felisan99/USB-2.0-4xPORTS-HUB/USB-Hub.kicad_pcb

## KiCad design USB-Hub.kicad_pcb (2025-02-19)

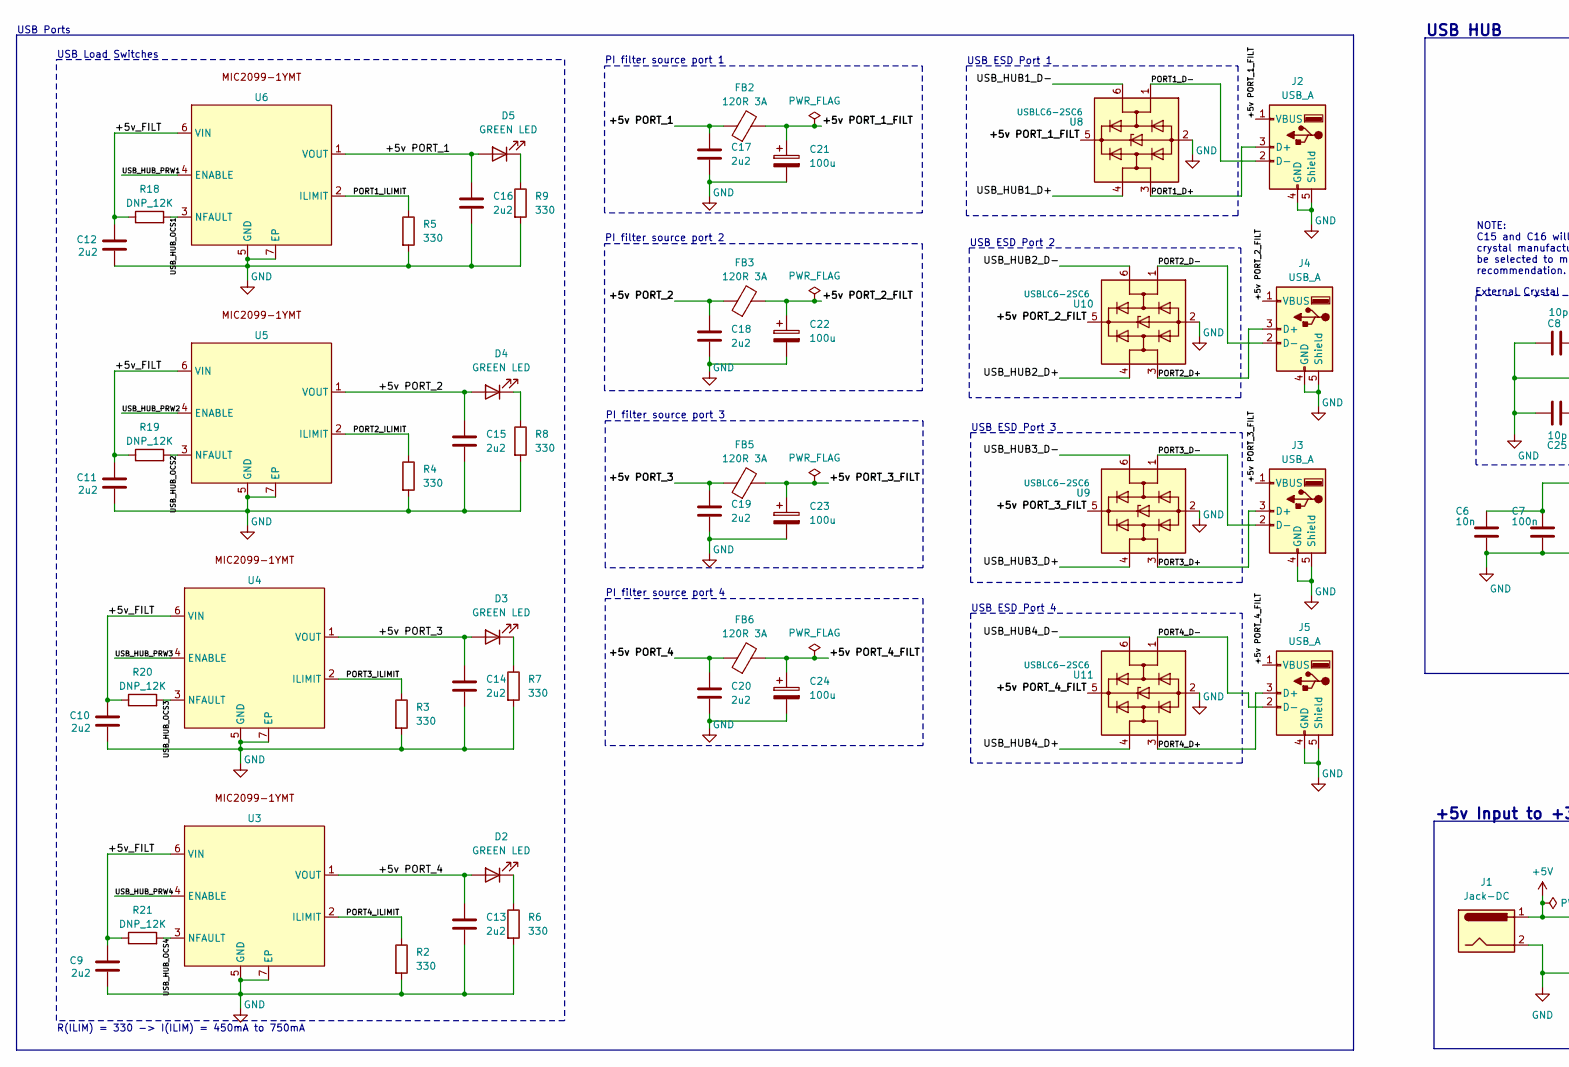
[picture p1: schematic USB-Hub.kicad_sch, USB Hub, part in row 1, column 1]

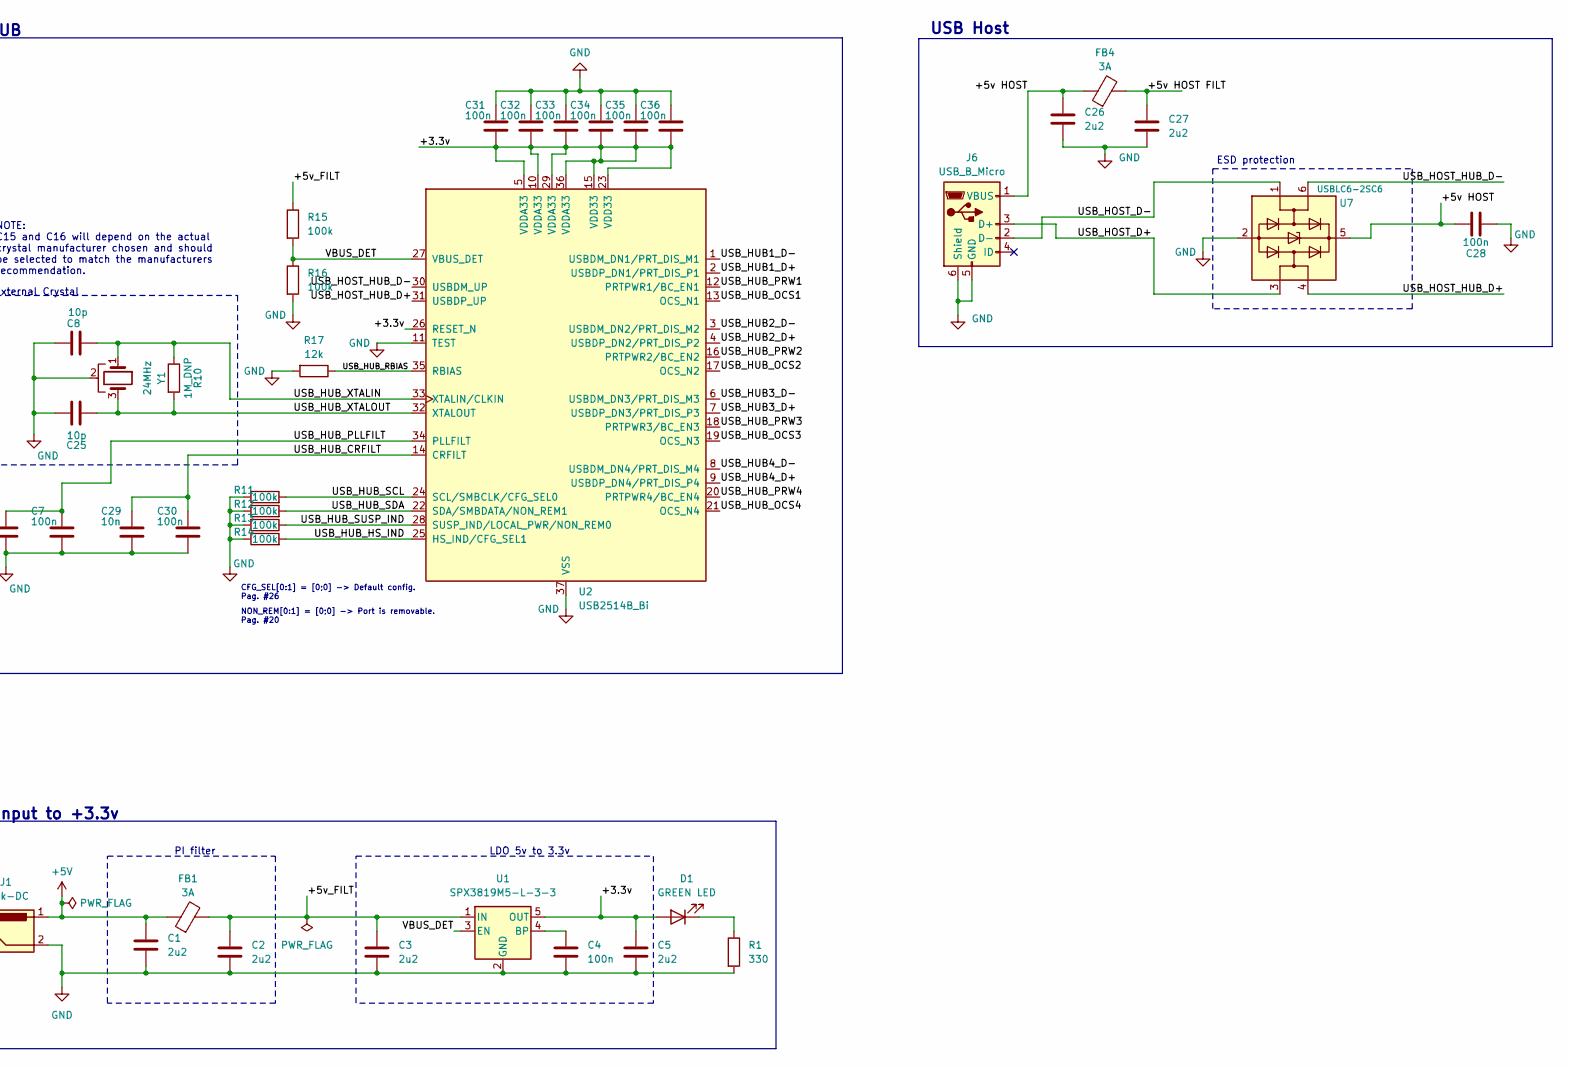
[picture p2: schematic USB-Hub.kicad_sch, USB Hub, part in row 1, column 2]

Parts:
C1, C2, C3, C5, C9, C10, C11, C12, C13, C14, C15, C16, C17, C18, C19, C20, C26, C27: 2u2; C_0805_2012Metric
C4, C7, C28, C30: 100n; C_0805_2012Metric
C6, C29: 10n; C_0603_1608Metric
C8, C25: 10p; C_0603_1608Metric
C21, C22, C23, C24: 100u; CP_Elec_6.3x3.9
C31, C32, C33, C34, C35, C36: 100n; C_0603_1608Metric
D1, D2, D3, D4, D5: GREEN LED; LED_0805_2012Metric
FB1, FB4: 3A; L_0201_0603Metric
FB2, FB3, FB5, FB6: 120R 3A; L_0201_0603Metric
J1: Jack-DC; BarrelJack_Horizontal
J2, J3, J4, J5: USB_A; USB_A_TE_292303-7_Horizontal
J6: USB_B_Micro; USB_Micro-B_Molex_47346-0001
R1, R2, R3, R4, R5, R6, R7, R8, R9: 330; R_0201_0603Metric
R10: 1M_DNP; R_0805_2012Metric
R11, R12, R13, R14, R15, R16: 100k; R_0805_2012Metric
R17: 12k; R_0201_0603Metric
R18, R19, R20, R21: DNP_12K; R_0201_0603Metric
U1: SPX3819M5-L-3-3; SOT-23-5
U2: USB2514B_Bi; QFN-36-1EP_6x6mm_P0.5mm_EP3.7x3.7mm
U3, U4, U5, U6: MIC2099-1YMT
U7, U8, U9, U10, U11: USBLC6-2SC6; SOT-23-6
Y1: 24MHz; Resonator_SMD-3Pin_7.2x3.0mm

Connections:
+5V: C1.1, FB1.1, J1.1
/+3.3v: C5.1, C31.2, C32.2, C33.2, C34.2, C35.2, C36.2, D1.2 (A), U1.5 (OUT), U2.5 (VDDA33), U2.10 (VDDA33), U2.15 (VDD33), U2.23 (VDD33), U2.26 (RESET_N), U2.29 (VDDA33), U2.36 (VDDA33)
/+5v HOST: C26.1, C28.1, FB4.1, J6.1 (VBUS), U7.5 (VBUS)
/+5v HOST FILT: C27.1, FB4.2
/+5v PORT_1: C16.1, C17.1, D5.2 (A), FB2.1, U6.1 (VOUT)
/+5v PORT_1_FILT: C21.1, FB2.2, J2.1 (VBUS), U8.5 (VBUS)
/+5v PORT_2: C15.1, C18.1, D4.2 (A), FB3.1, U5.1 (VOUT)
/+5v PORT_2_FILT: C22.1, FB3.2, J4.1 (VBUS), U10.5 (VBUS)
/+5v PORT_3: C14.1, C19.1, D3.2 (A), FB5.1, U4.1 (VOUT)
/+5v PORT_3_FILT: C23.1, FB5.2, J3.1 (VBUS), U9.5 (VBUS)
/+5v PORT_4: C13.1, C20.1, D2.2 (A), FB6.1, U3.1 (VOUT)
/+5v PORT_4_FILT: C24.1, FB6.2, J5.1 (VBUS), U11.5 (VBUS)
/+5v_FILT: C2.1, C3.1, C9.1, C10.1, C11.1, C12.1, FB1.2, R15.1, R18.1, R19.1, R20.1, R21.1, U1.1 (IN), U3.6 (VIN), U4.6 (VIN), U5.6 (VIN), U6.6 (VIN)
/PORT1_D+: J2.3 (D+), U8.3 (I/O2)
/PORT1_D-: J2.2 (D-), U8.1 (I/O1)
/PORT1_ILIMIT: R5.1, U6.2 (ILIMIT)
/PORT2_D+: J4.3 (D+), U10.3 (I/O2)
/PORT2_D-: J4.2 (D-), U10.1 (I/O1)
/PORT2_ILIMIT: R4.1, U5.2 (ILIMIT)
/PORT3_D+: J3.3 (D+), U9.3 (I/O2)
/PORT3_D-: J3.2 (D-), U9.1 (I/O1)
/PORT3_ILIMIT: R3.1, U4.2 (ILIMIT)
/PORT4_D+: J5.3 (D+), U11.3 (I/O2)
/PORT4_D-: J5.2 (D-), U11.1 (I/O1)
/PORT4_ILIMIT: R2.1, U3.2 (ILIMIT)
/USB_HOST_D+: J6.3 (D+), U7.3 (I/O2)
/USB_HOST_D-: J6.2 (D-), U7.1 (I/O1)
/USB_HOST_HUB_D+: U2.31 (USBDP_UP), U7.4 (I/O2)
/USB_HOST_HUB_D-: U2.30 (USBDM_UP), U7.6 (I/O1)
/USB_HUB1_D+: U2.2 (USBDP_DN1/PRT_DIS_P1), U8.4 (I/O2)
/USB_HUB1_D-: U2.1 (USBDM_DN1/PRT_DIS_M1), U8.6 (I/O1)
/USB_HUB2_D+: U2.4 (USBDP_DN2/PRT_DIS_P2), U10.4 (I/O2)
/USB_HUB2_D-: U2.3 (USBDM_DN2/PRT_DIS_M2), U10.6 (I/O1)
/USB_HUB3_D+: U2.7 (USBDP_DN3/PRT_DIS_P3), U9.4 (I/O2)
/USB_HUB3_D-: U2.6 (USBDM_DN3/PRT_DIS_M3), U9.6 (I/O1)
/USB_HUB4_D+: U2.9 (USBDP_DN4/PRT_DIS_P4), U11.4 (I/O2)
/USB_HUB4_D-: U2.8 (USBDM_DN4/PRT_DIS_M4), U11.6 (I/O1)
/USB_HUB_CRFILT: C29.1, C30.1, U2.14 (CRFILT)
/USB_HUB_HS_IND: R14.2, U2.25 (HS_IND/CFG_SEL1)
/USB_HUB_OCS1: R18.2, U2.13 (OCS_N1), U6.3 (NFAULT)
/USB_HUB_OCS2: R19.2, U2.17 (OCS_N2), U5.3 (NFAULT)
/USB_HUB_OCS3: R20.2, U2.19 (OCS_N3), U4.3 (NFAULT)
/USB_HUB_OCS4: R21.2, U2.21 (OCS_N4), U3.3 (NFAULT)
/USB_HUB_PLLFILT: C6.1, C7.1, U2.34 (PLLFILT)
/USB_HUB_PRW1: U2.12 (PRTPWR1/BC_EN1), U6.4 (ENABLE)
/USB_HUB_PRW2: U2.16 (PRTPWR2/BC_EN2), U5.4 (ENABLE)
/USB_HUB_PRW3: U2.18 (PRTPWR3/BC_EN3), U4.4 (ENABLE)
/USB_HUB_PRW4: U2.20 (PRTPWR4/BC_EN4), U3.4 (ENABLE)
/USB_HUB_RBIAS: R17.1, U2.35 (RBIAS)
/USB_HUB_SCL: R11.2, U2.24 (SCL/SMBCLK/CFG_SEL0)
/USB_HUB_SDA: R12.2, U2.22 (SDA/SMBDATA/NON_REM1)
/USB_HUB_SUSP_IND: R13.1, U2.28 (SUSP_IND/LOCAL_PWR/NON_REM0)
/USB_HUB_XTALIN: C8.1, R10.1, U2.33 (XTALIN/CLKIN), Y1.1
/USB_HUB_XTALOUT: C25.2, R10.2, U2.32 (XTALOUT), Y1.3
/VBUS_DET: R15.2, R16.1, U1.3 (EN), U2.27 (VBUS_DET)
GND: C1.2, C2.2, C3.2, C4.2, C5.2, C6.2, C7.2, C8.2, C9.2, C10.2, C11.2, C12.2, C13.2, C14.2, C15.2, C16.2, C17.2, C18.2, C19.2, C20.2, C21.2, C22.2, C23.2, C24.2, C25.1, C26.2, C27.2, C28.2, C29.2, C30.2, C31.1, C32.1, C33.1, C34.1, C35.1, C36.1, J1.2, J2.4 (GND), J2.5 (Shield), J3.4 (GND), J3.5 (Shield), J4.4 (GND), J4.5 (Shield), J5.4 (GND), J5.5 (Shield), J6.5 (GND), J6.6 (Shield), R1.2, R2.2, R3.2, R4.2, R5.2, R6.2, R7.2, R8.2, R9.2, R11.1, R12.1, R13.2, R14.1, R16.2, R17.2, U1.2 (GND), U2.11 (TEST), U2.37 (VSS), U3.5 (GND), U3.7 (EP), U4.5 (GND), U4.7 (EP), U5.5 (GND), U5.7 (EP), U6.5 (GND), U6.7 (EP), U7.2 (GND), U8.2 (GND), U9.2 (GND), U10.2 (GND), U11.2 (GND), Y1.2
unnamed: D1.1 (K), R1.1
unnamed: D2.1 (K), R6.1
unnamed: D3.1 (K), R7.1
unnamed: D4.1 (K), R8.1
unnamed: D5.1 (K), R9.1
unnamed: C4.1, U1.4 (BP)

Notes on the sheet:
PI filter source port 4
+5v Input to +3.3v
R(ILIM) = 330 -> I(ILIM) = 450mA to 750mA
USB Host
USB ESD Port 2
USB HUB
PI filter
LDO 5v to 3.3v
NOTE: C15 and C16 will depend on the actual crystal manufacturer chosen and should be selected to match the manufacturers recommendation.
USB Load Switches
USB ESD Port 1
USB Ports
USB ESD Port 4
PI filter source port 3
NON_REM[0:1] = [0;0] -> Port is removable. Pag. #20
ESD protection
External Crystal
USB ESD Port 3
PI filter source port 2
CFG_SEL[0:1] = [0;0] -> Default config. Pag. #26
PI filter source port 1

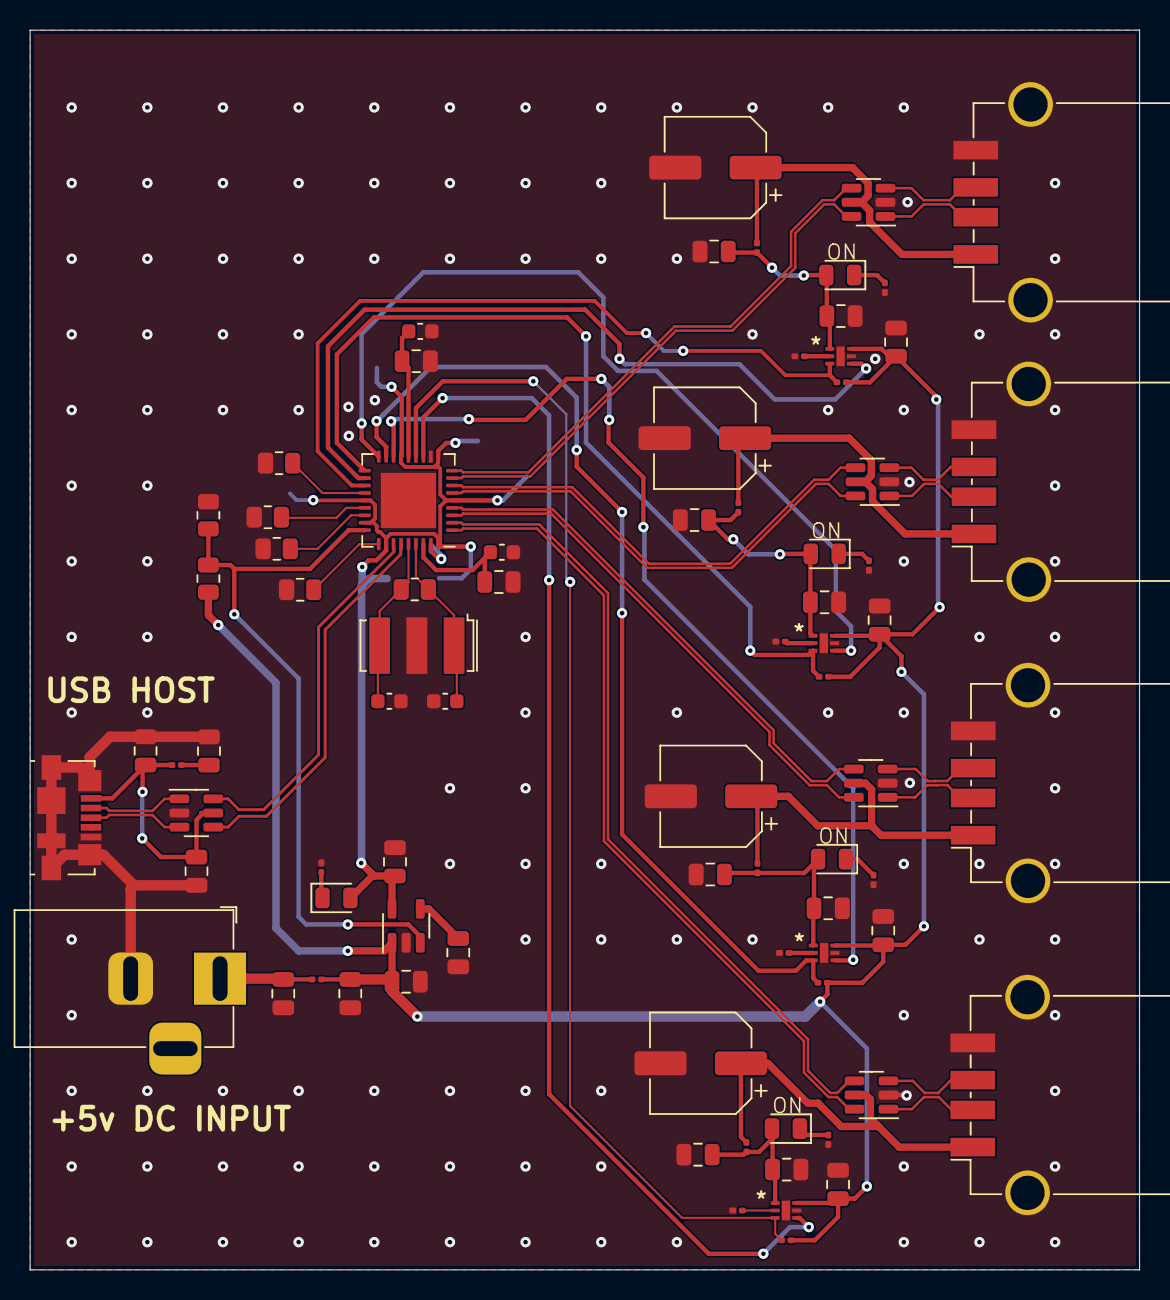
[picture p3: board USB-Hub.kicad_pcb from above]

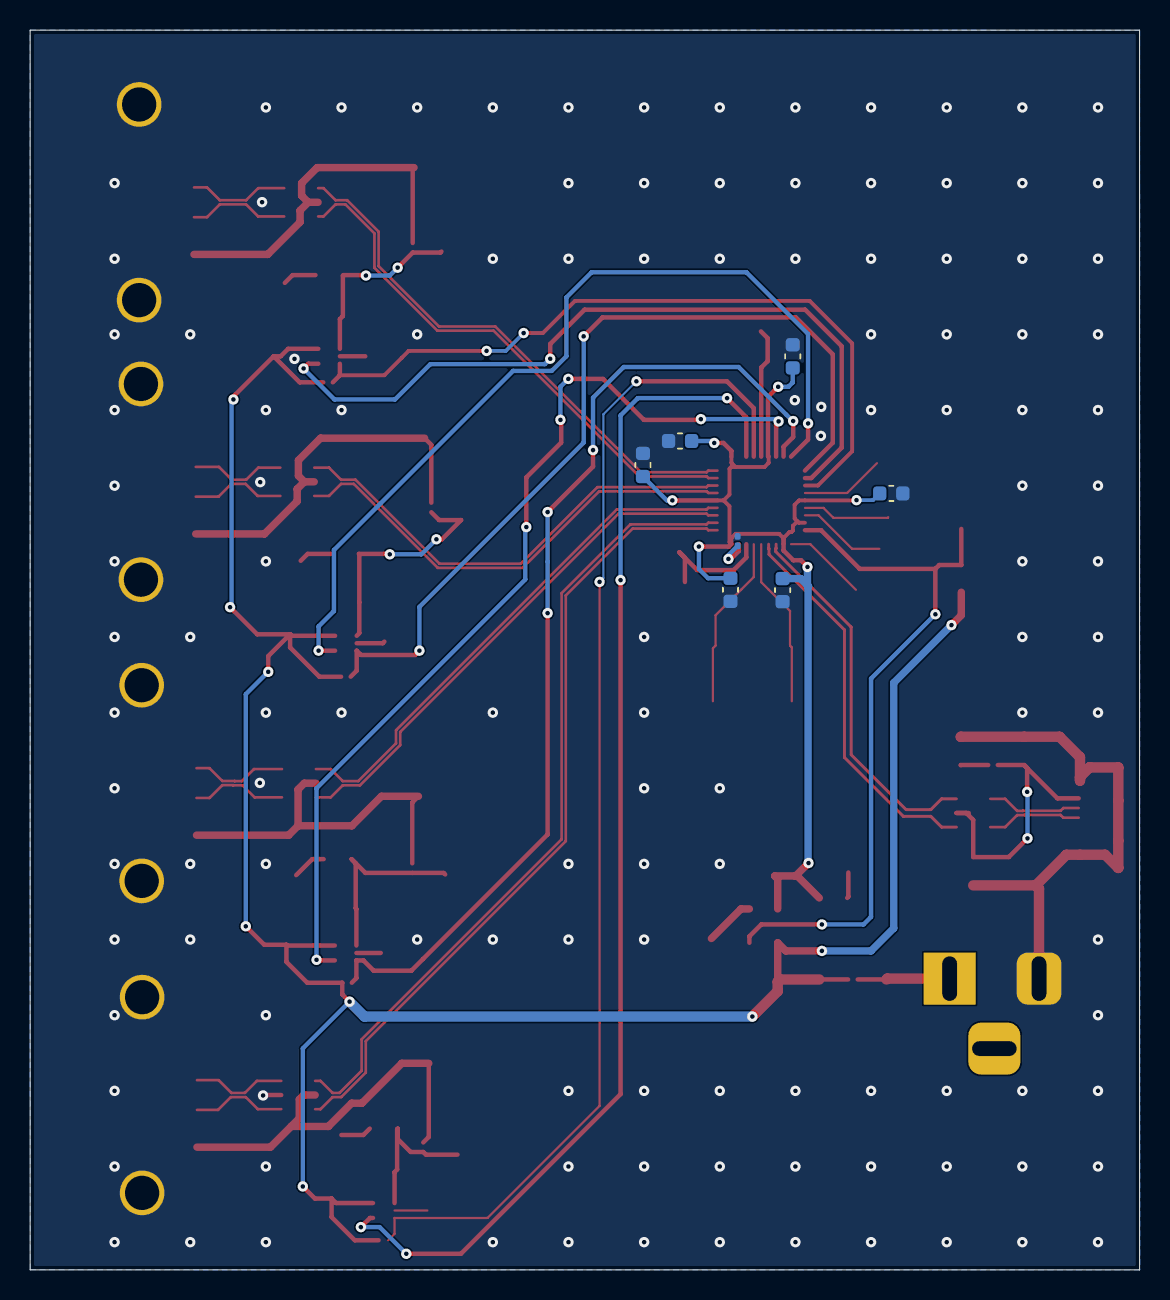
[picture p4: board USB-Hub.kicad_pcb from below]

Board: 4 copper layers, 74.5 x 83.2 mm, 86 parts (7 on the bottom side), 62 nets.
